yunluo001/stm32-snake/docs/MAX7219接线图_5根线.png

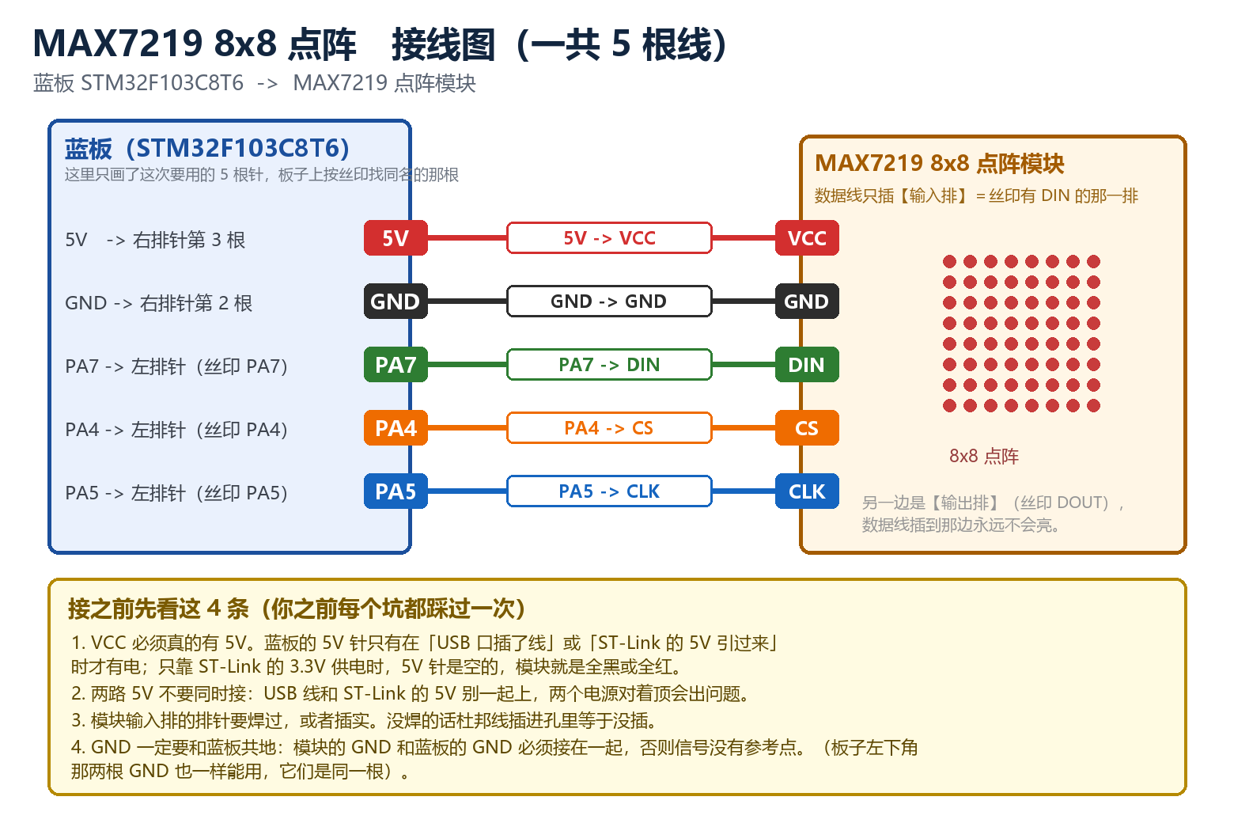
docs/MAX7219接线图_5根线.png
