yunluo001/stm32-snake/docs/双OLED接线图.png

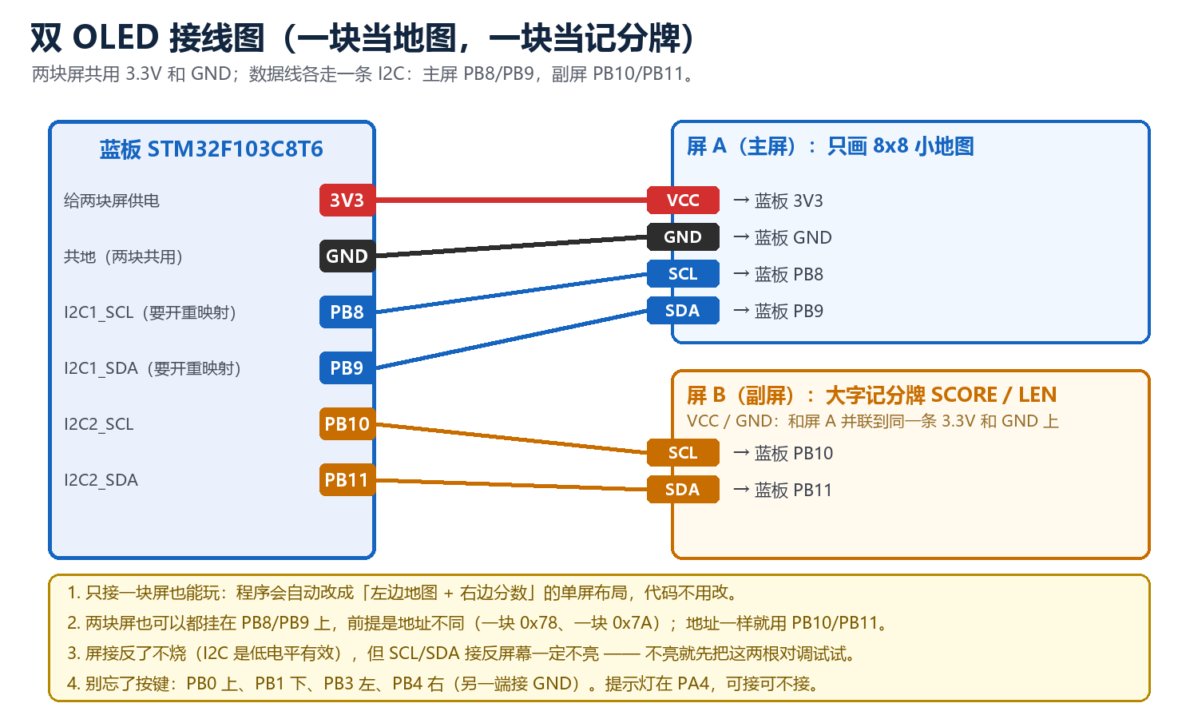
docs/双OLED接线图.png
