yunluo001/stm32-snake/1083.ioc

Mcu.UserName=STM32F103C8Tx
PA13.Signal=SYS_JTMS-SWDIO
PA14.Signal=SYS_JTCK-SWCLK
PA4.Signal=GPIO_Output
PA5.Signal=GPIO_Output
PA6.Signal=GPIO_Output
PA7.Signal=GPIO_Output
PB0.Signal=GPIO_Input
PB1.Signal=GPIO_Input
PB10.Signal=I2C2_SCL
PB11.Signal=I2C2_SDA
PB3.Signal=GPIO_Input
PB4.Signal=GPIO_Input
PB8.Signal=I2C1_SCL
PB9.Signal=I2C1_SDA
PD0-OSC_IN.Signal=RCC_OSC_IN
PD1-OSC_OUT.Signal=RCC_OSC_OUT
