yunluo001/stm32-snake/(commit log)

2026-10-11 STM32 8x8 贪吃蛇：OLED 显示 + 5 按键 + 蜂鸣器，含 MAX7219 点阵驱动
2026-10-11 README：补上界面示意与接线图
